tremrej/ErcpBearingSpool/stls/spacer1mm_diff.png

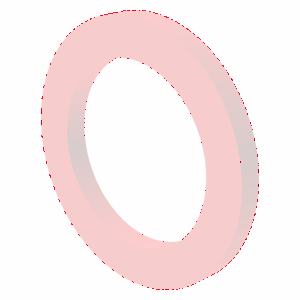
stls/spacer1mm_diff.png
