tremrej/ErcpBearingSpool/stls/mainBodyNoShoulder.stl

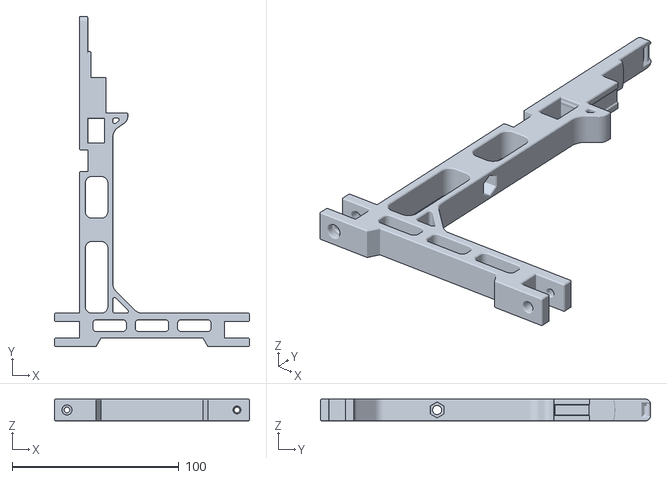
[picture p20: CAD file, 2023-10-30]
stls/mainBodyNoShoulder.stl
117.0 x 198.0 x 13.0
