tremrej/ErcpBearingSpool/stls/spacer1mm.stl

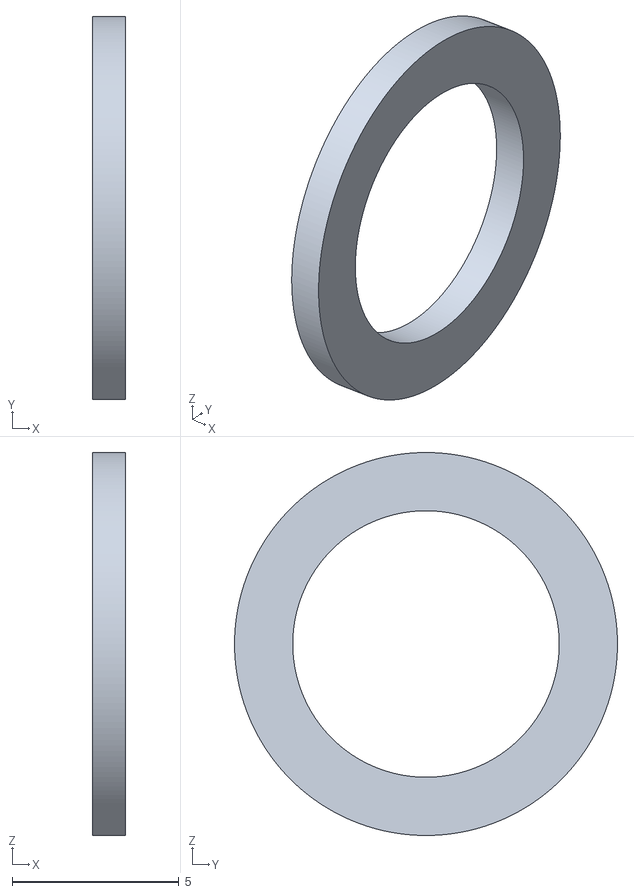
[picture p21: CAD file, 2023-10-30]
stls/spacer1mm.stl
1.00 x 11.5 x 11.5
