tremrej/ErcpBearingSpool/stls/roller.stl

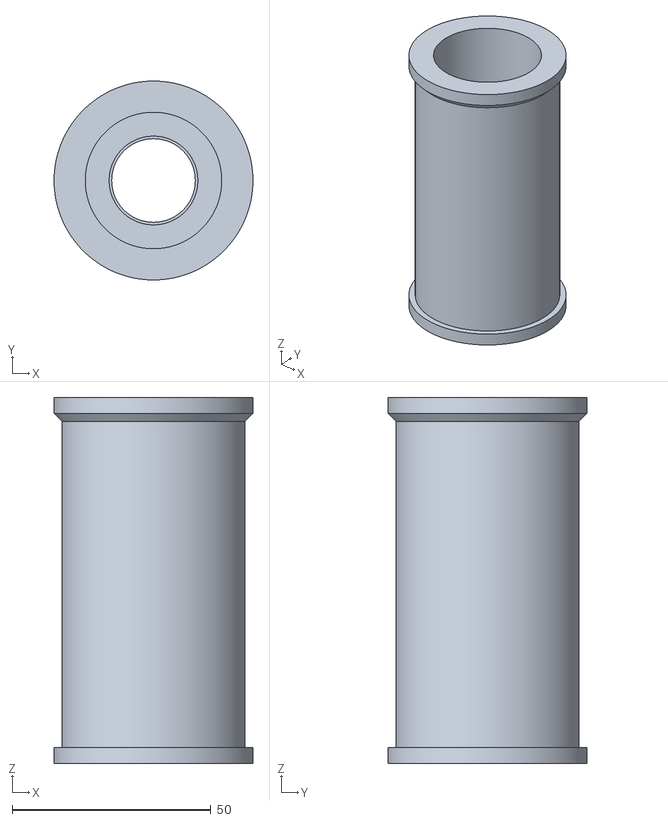
[picture p22: CAD file, 2023-10-30]
stls/roller.stl
50.0 x 50.0 x 92.0
