tremrej/ErcpBearingSpool/stls/spacer3mm.stl

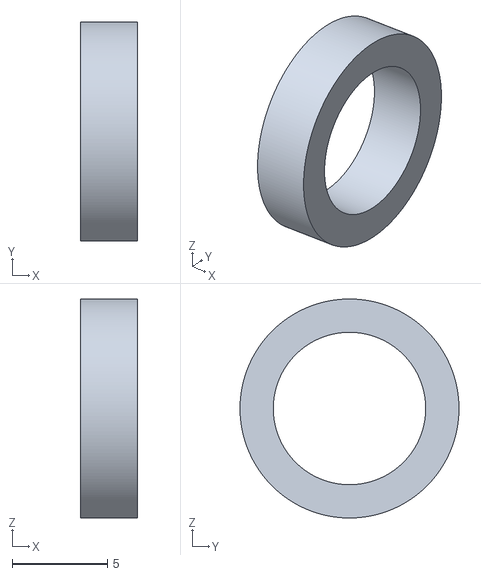
[picture p23: CAD file, 2023-10-29]
stls/spacer3mm.stl
3.00 x 11.5 x 11.5
