tremrej/ErcpBearingSpool/bom/handle_part1_assembly.txt

handle_part1_assembly:
Vitamins:
  1 Heatfit insert M3 x 4mm
