tremrej/ErcpBearingSpool/bom/optional_mainBody_assembly.txt

optional_mainBody_assembly:
Printed:
  1 mainBodyNoShoulder.stl
