tremrej/ErcpBearingSpool/bom/main_assembly.txt

main_assembly:
Vitamins:
  1 Threaded rod M8 x 88mm

Printed:
  1 bearingSH_5_16.stl
  1 nut_5_16.stl
  1 nut_M8.stl
  1 spacer1mm.stl
  1 spacer3mm.stl

Assemblies:
  1 handle_part2_assembly
  1 optional_mainBody_assembly
  1 roll_assembly
