tremrej/ErcpBearingSpool/assemblies/handle_part1_assembled.png

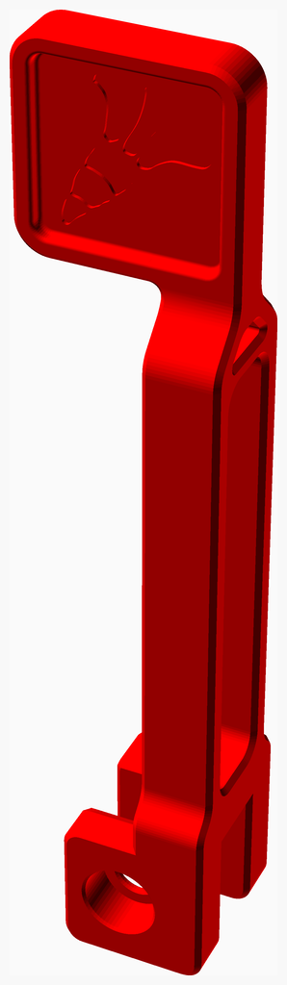
assemblies/handle_part1_assembled.png
