tremrej/ErcpBearingSpool/assemblies/handle_part1_assembly.png

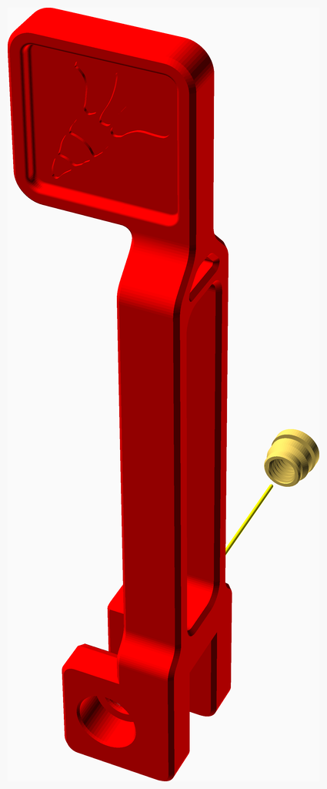
assemblies/handle_part1_assembly.png
