tremrej/ErcpBearingSpool/assemblies/handle_part2_assembled.png

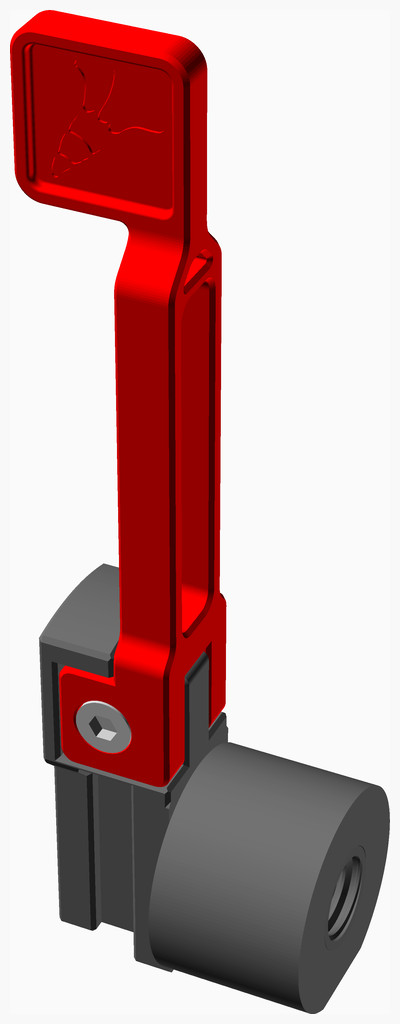
assemblies/handle_part2_assembled.png
