tremrej/ErcpBearingSpool/assemblies/handle_part2_assembly.png

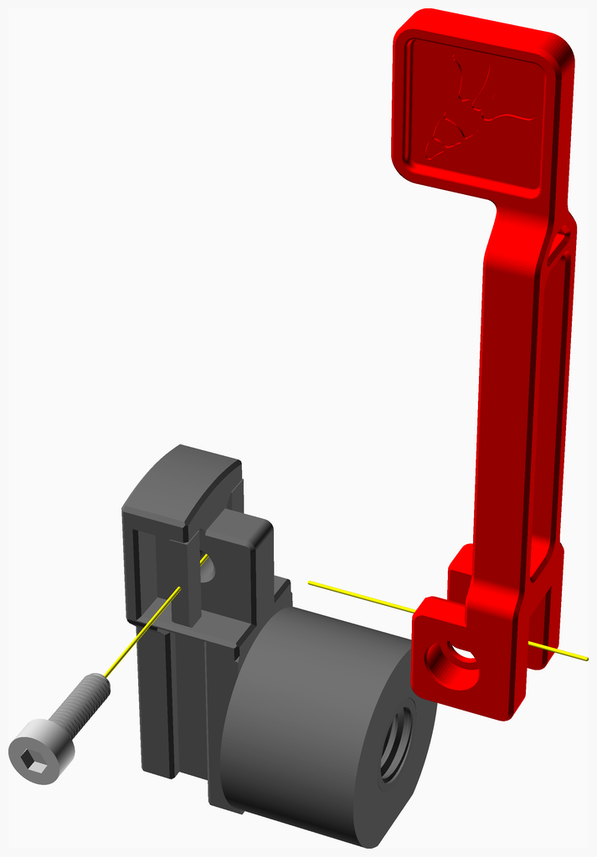
assemblies/handle_part2_assembly.png
