tremrej/ErcpBearingSpool/assemblies/main_assembled_tn.png

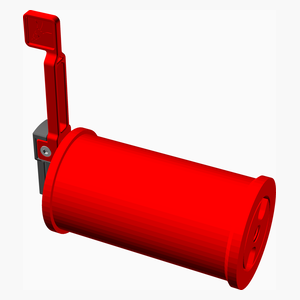
assemblies/main_assembled_tn.png
