tremrej/ErcpBearingSpool/assemblies/main_assembly_tn.png

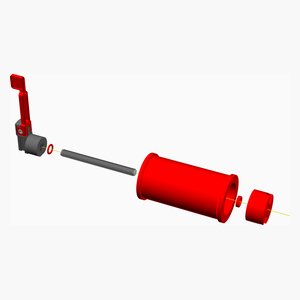
assemblies/main_assembly_tn.png
