tremrej/ErcpBearingSpool/assemblies/optional_mainBody_assembled.png

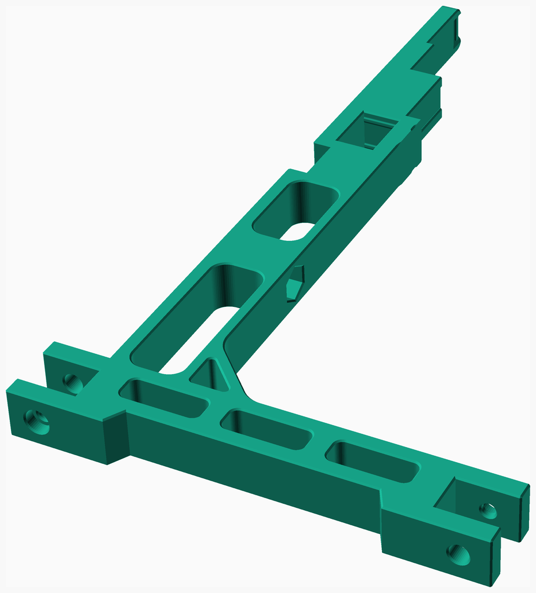
assemblies/optional_mainBody_assembled.png
