tremrej/ErcpBearingSpool/assemblies/roll_assembled.png

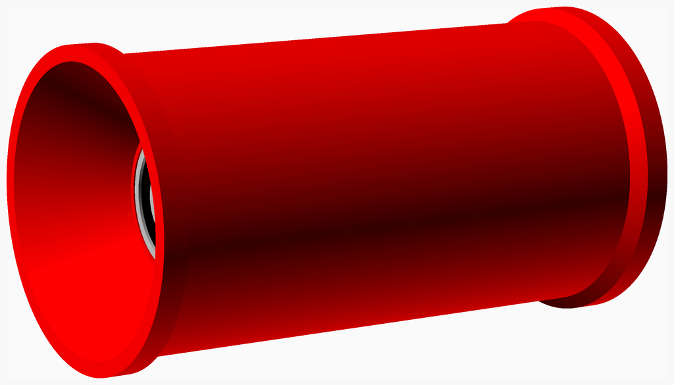
assemblies/roll_assembled.png
