tremrej/ErcpBearingSpool/assemblies/roll_assembled_diff.png

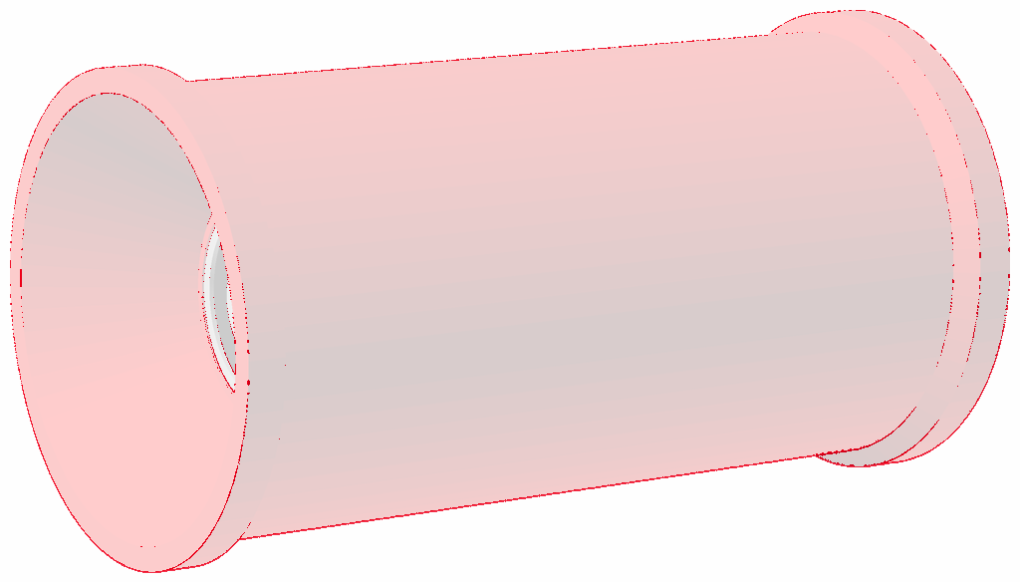
assemblies/roll_assembled_diff.png
