tremrej/ErcpBearingSpool/assemblies/roll_assembly.png

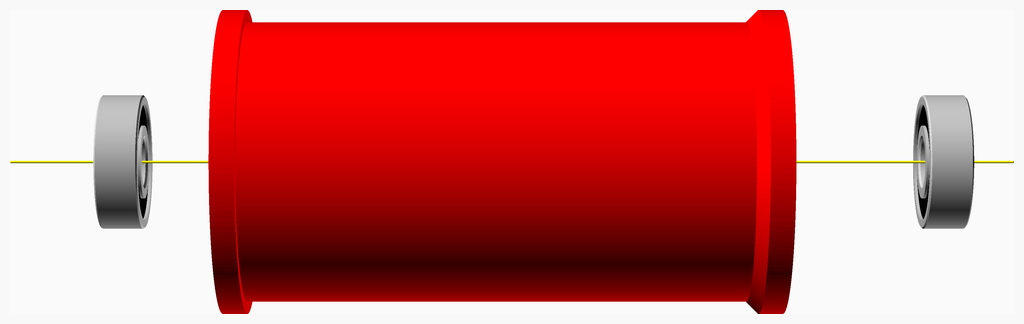
assemblies/roll_assembly.png
