tremrej/ErcpBearingSpool/assemblies/roll_assembly_diff.png

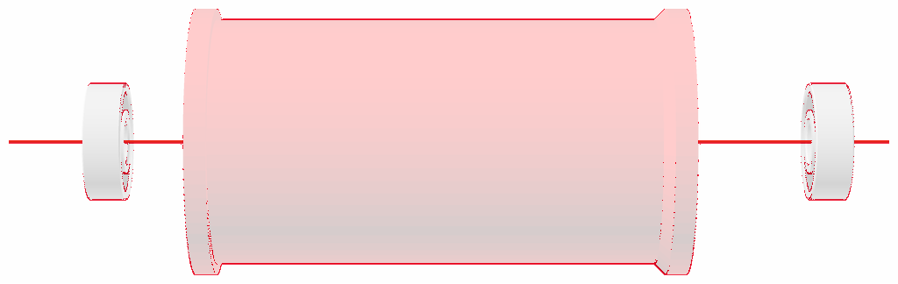
assemblies/roll_assembly_diff.png
